xesscorp/XuLA/pcb/.solderpad/photo.jpg

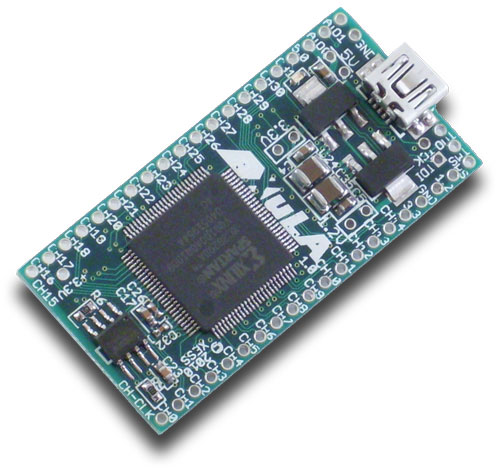
pcb/.solderpad/photo.jpg
