xesscorp/XuLA/(threads)

Thread 1 (2016-05-18):

Quartus ii 13.1 web edition failed to compile the coding

zackhaikal, 2016-05-18:
My project aims to use the DE1 SoC FPGA board for obstacle and these are the components used:
i.   ultrasonic sensor
ii.  TRDB LTM LCD
iii. TRDB D5M
when compiling the coding, i got this error
why?
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

xesscorp, 2016-05-18:
This issue isn't related to the XuLA Board in any way.

Closed 2016-05-18.
