xesscorp/XuLA/pcb/.solderpad/board.pdf

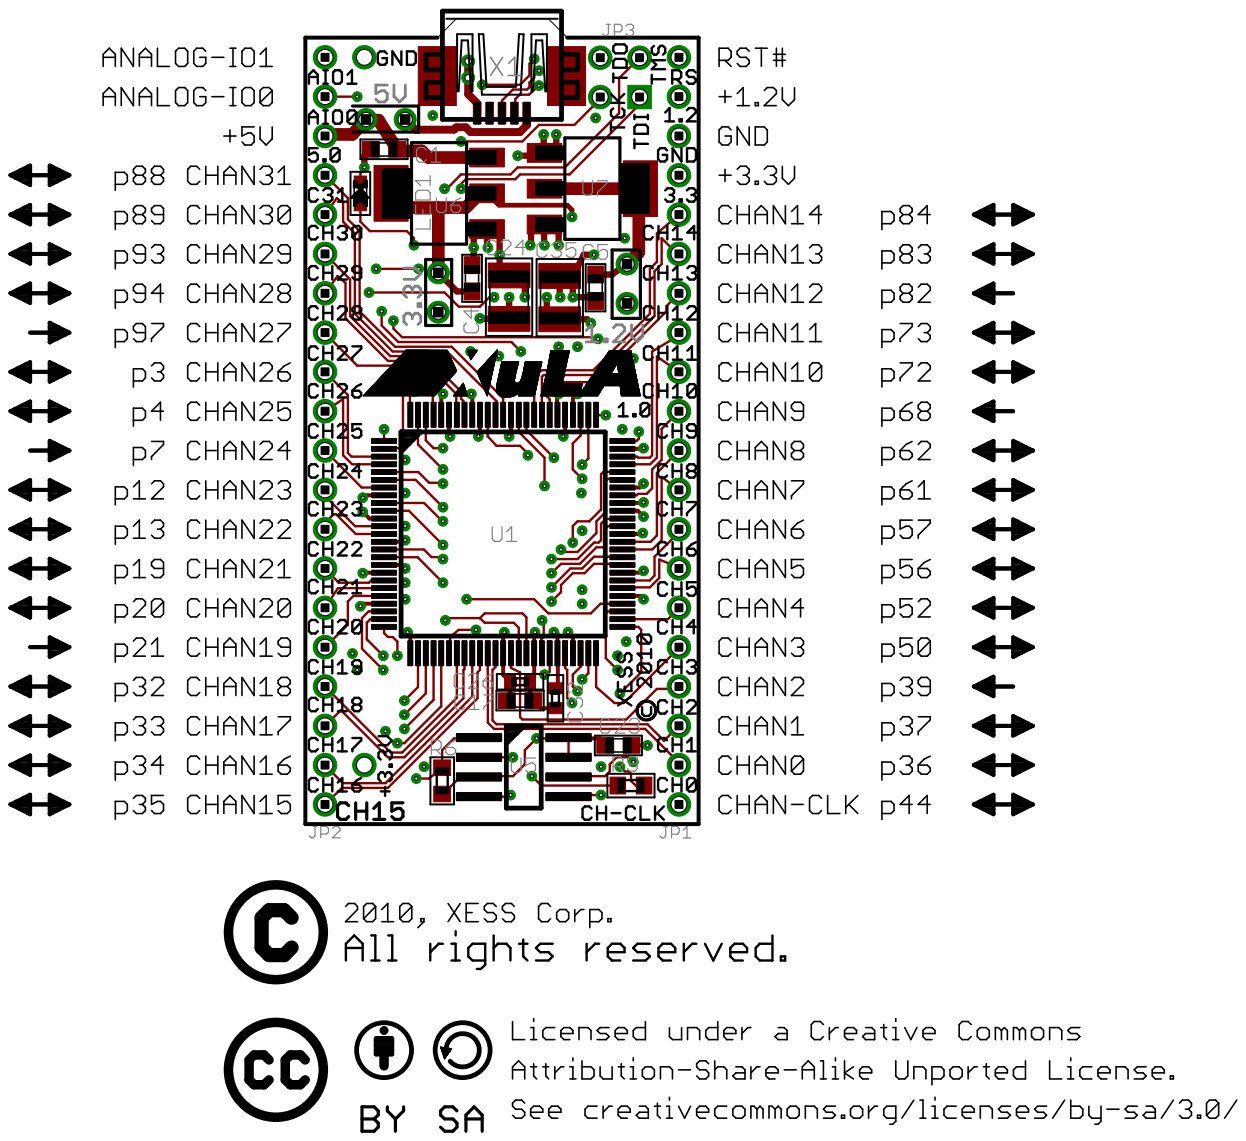
[picture p30: page 1]
