xesscorp/XuLA/pcb/.solderpad/schematic.pdf

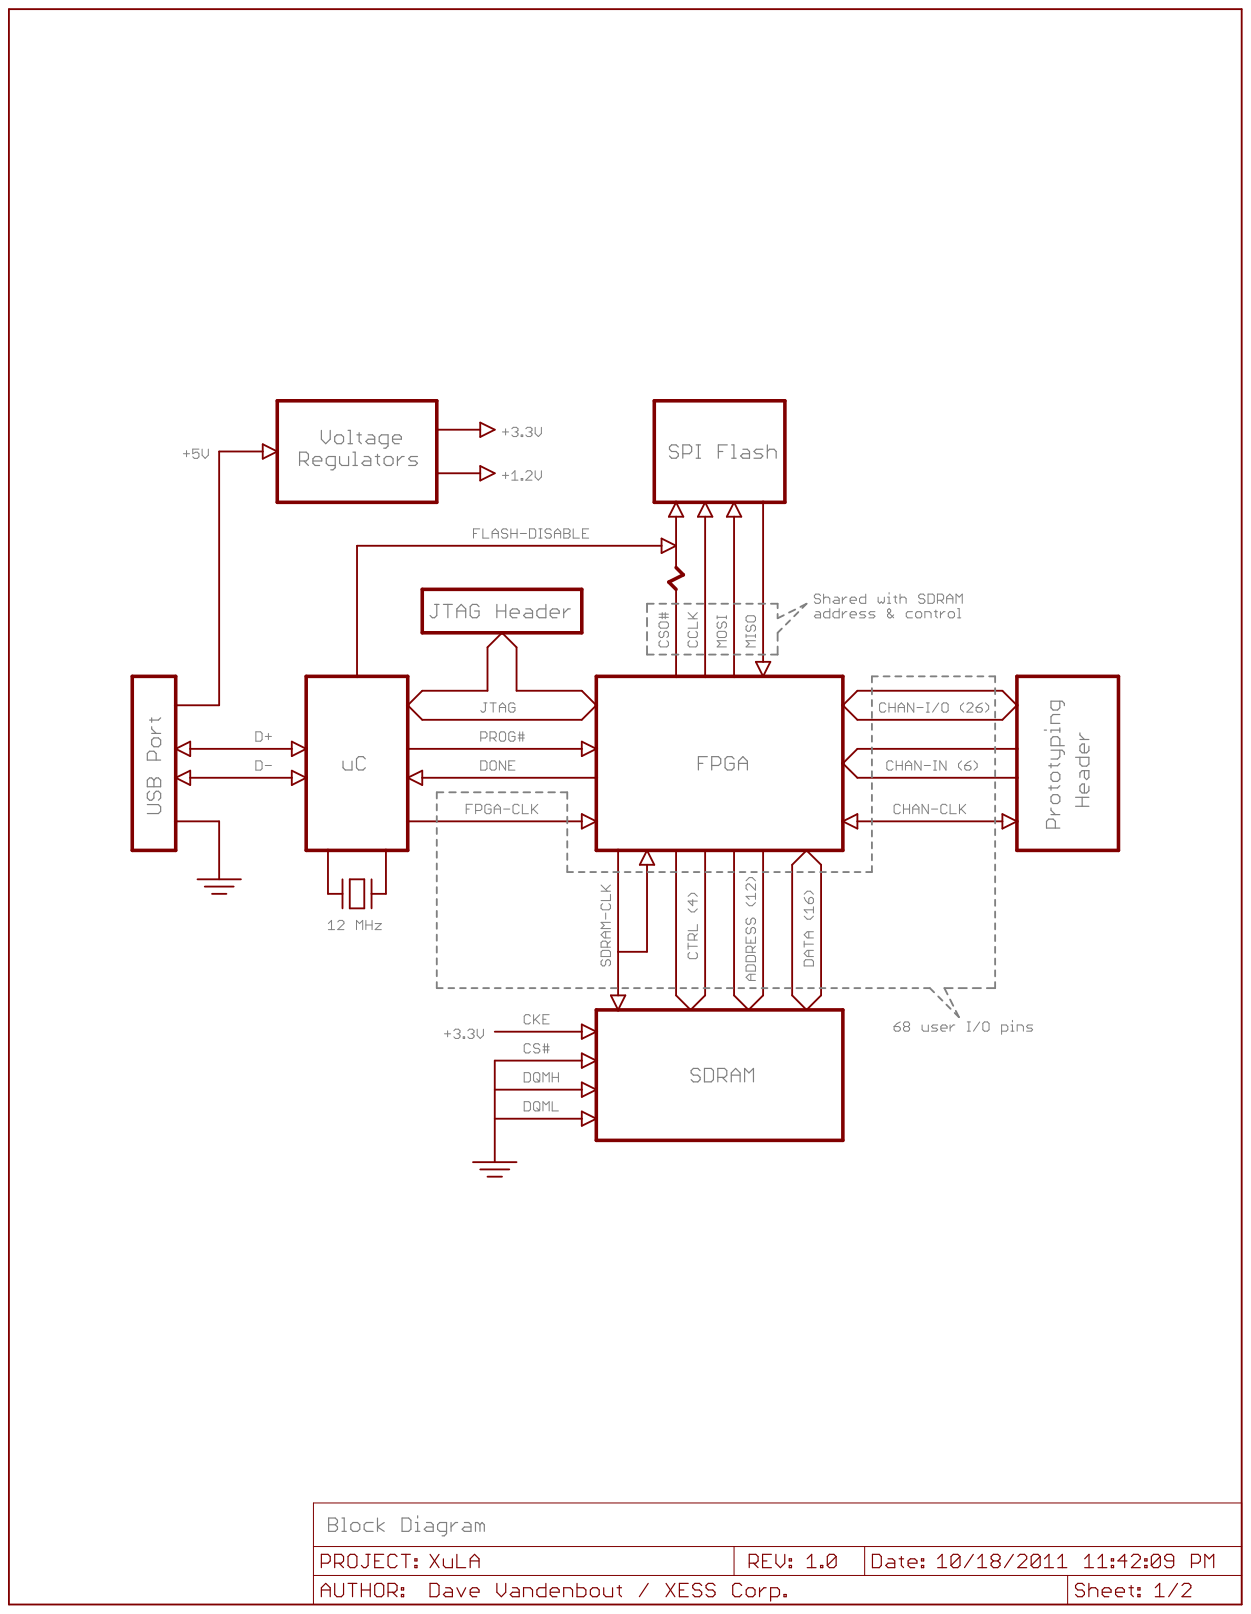
[picture p31: page 1]

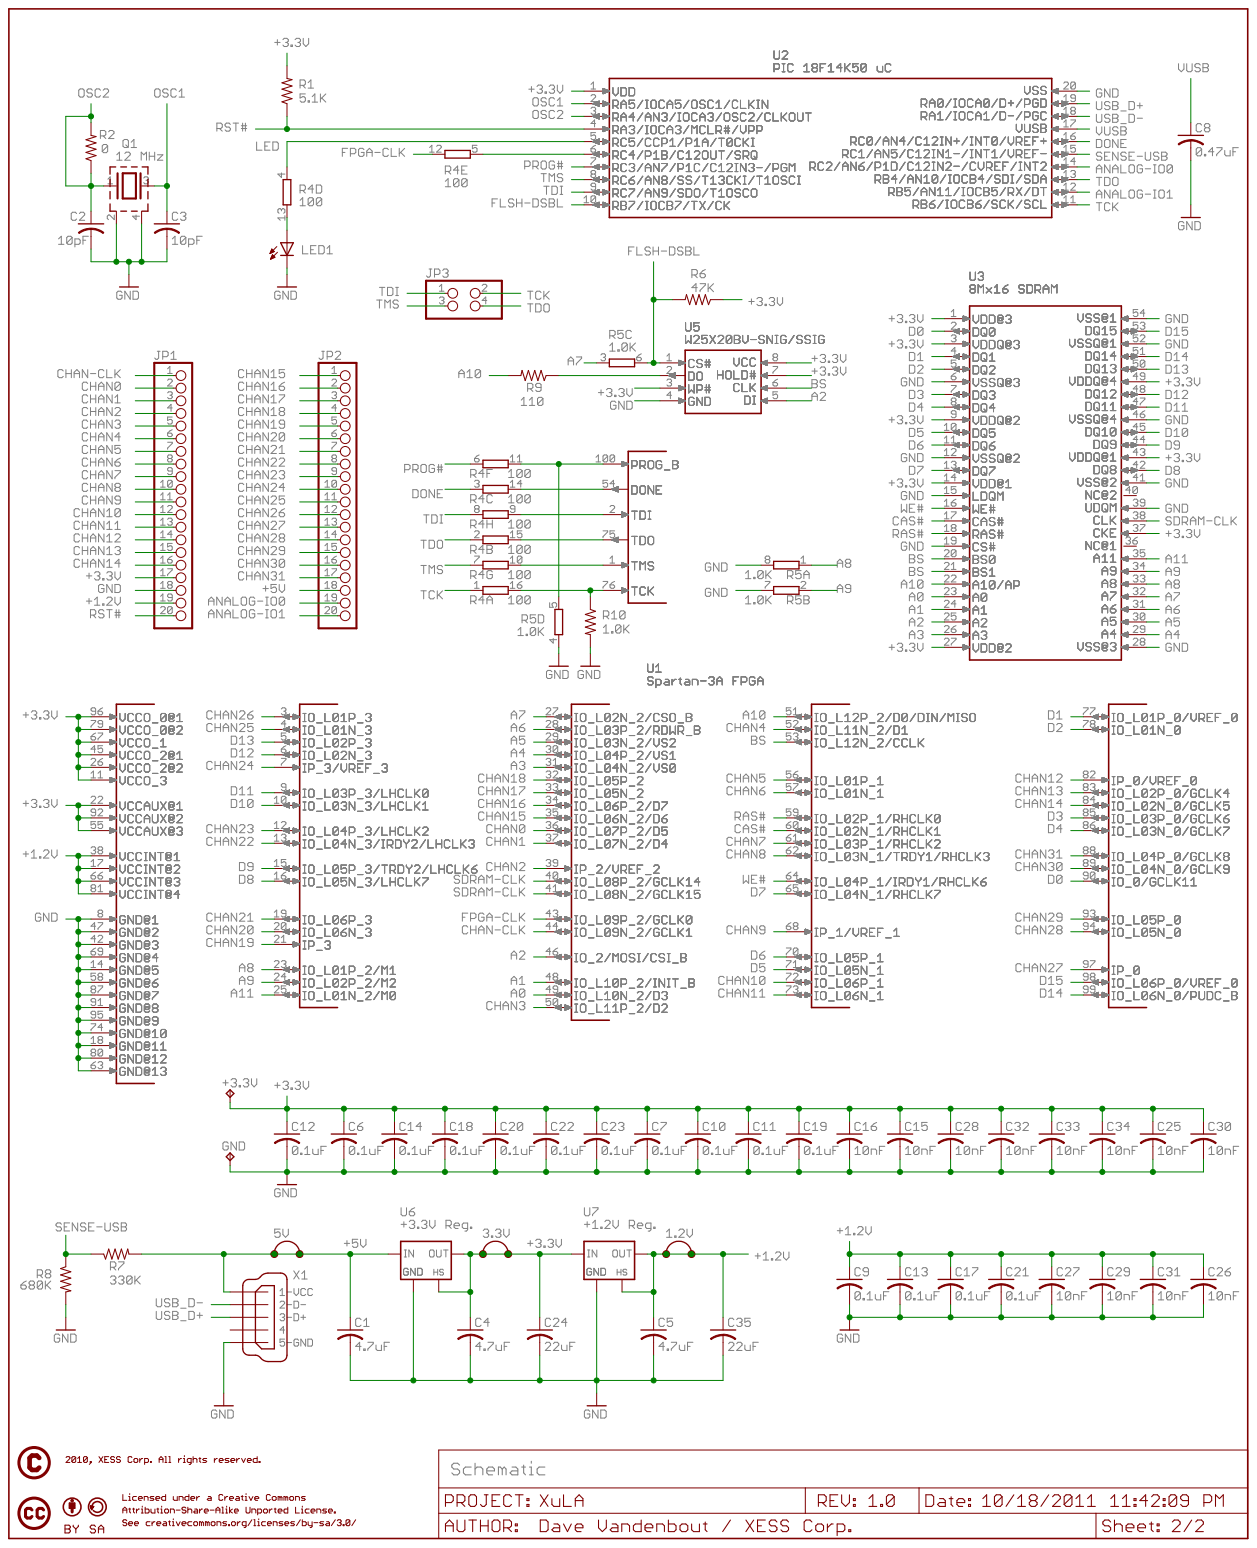
[picture p32: page 2]
