xesscorp/XuLA/fmw/user/main.c

//*********************************************************************
// Copyright (C) 2010 Dave Vanden Bout / XESS Corp. / www.xess.com
//
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
//====================================================================
//
// Module Description:
//  This module boots up the USB-to-JTAG firmware.  Look in user.c
//  for the code that does the majority of the work.
//
//********************************************************************

#include "USB/usb.h"
#include "USB/usb_function_generic.h"
#include "HardwareProfile.h"
#include "user.h"
#include "Blinker.h"

static void InitializeSystem( void );
void USBDeviceTasks( void );
void YourHighPriorityISRCode( void );
void YourLowPriorityISRCode( void );
void USBCBInitEP( void ); // This callback function was moved to user.c.

/** VECTOR REMAPPING *******************************************/
#define REMAPPED_RESET_VECTOR_ADDRESS 0x800
#define REMAPPED_HIGH_INTERRUPT_VECTOR_ADDRESS 0x808
#define REMAPPED_LOW_INTERRUPT_VECTOR_ADDRESS 0x818

#pragma code REMAPPED_RESET_VECTOR = REMAPPED_RESET_VECTOR_ADDRESS
extern void _startup( void );        // See c018i.c in your C18 compiler dir
void _reset( void )
{
    _asm goto _startup _endasm
}



#pragma code
#pragma interrupt YourHighPriorityISRCode
void YourHighPriorityISRCode()
{
    //Check which interrupt flag caused the interrupt.
    //Service the interrupt
    //Clear the interrupt flag
    //Etc.
    #if defined( USB_INTERRUPT )
    USBDeviceTasks();
    #endif
}   //This return will be a "retfie fast", since this is in a #pragma interrupt section



#pragma code REMAPPED_HIGH_INTERRUPT_VECTOR = REMAPPED_HIGH_INTERRUPT_VECTOR_ADDRESS
void Remapped_High_ISR( void )
{
    _asm goto YourHighPriorityISRCode _endasm
}



#pragma code
#pragma interruptlow YourLowPriorityISRCode
void YourLowPriorityISRCode()
{
    Blinker();
}   //This return will be a "retfie fast", since this is in a #pragma interrupt section



#pragma code REMAPPED_LOW_INTERRUPT_VECTOR = REMAPPED_LOW_INTERRUPT_VECTOR_ADDRESS
void Remapped_Low_ISR( void )
{
    _asm goto YourLowPriorityISRCode _endasm
}



#pragma code

void main( void )
{
    InitializeSystem();

    #if defined( USB_INTERRUPT )
    USBDeviceAttach();
    #endif

    while ( 1 )
    {
        #if defined( USB_POLLING )
        // Check bus status and service USB interrupts.
        USBDeviceTasks(); // Call every 100us or so (takes ~50 instruction cycles before it returns).
        #endif

        ProcessIO();
    }
}



static void InitializeSystem( void )
{
    UserInit();
    USBDeviceInit();
}



// ******************************************************************************************************
// ************** USB Callback Functions ****************************************************************
// ******************************************************************************************************
// The USB firmware stack will call the callback functions USBCBxxx() in response to certain USB related
// events.  For example, if the host PC is powering down, it will stop sending out Start of Frame (SOF)
// packets to your device.  In response to this, all USB devices are supposed to decrease their power
// consumption from the USB Vbus to <2.5mA each.  The USB module detects this condition (which according
// to the USB specifications is 3+ms of no bus activity/SOF packets) and then calls the USBCBSuspend()
// function.  You should modify these callback functions to take appropriate actions for each of these
// conditions.  For example, in the USBCBSuspend(), you may wish to add code that will decrease power
// consumption from Vbus to <2.5mA (such as by clock switching, turning off LEDs, putting the
// microcontroller to sleep, etc.).  Then, in the USBCBWakeFromSuspend() function, you may then wish to
// add code that undoes the power saving things done in the USBCBSuspend() function.

// The USBCBSendResume() function is special, in that the USB stack will not automatically call this
// function.  This function is meant to be called from the application firmware instead.  See the
// additional comments near the function.

/******************************************************************************
 * Function:        void USBCBSuspend(void)
 *
 * PreCondition:    None
 *
 * Input:           None
 *
 * Output:          None
 *
 * Side Effects:    None
 *
 * Overview:        Call back that is invoked when a USB suspend is detected
 *
 * Note:            None
 *****************************************************************************/
void USBCBSuspend( void )
{
    //Example power saving code.  Insert appropriate code here for the desired
    //application behavior.  If the microcontroller will be put to sleep, a
    //process similar to that shown below may be used:

    //ConfigureIOPinsForLowPower();
    //SaveStateOfAllInterruptEnableBits();
    //DisableAllInterruptEnableBits();
    //EnableOnlyTheInterruptsWhichWillBeUsedToWakeTheMicro();	//should enable at least USBActivityIF as a wake source
    //Sleep();
    //RestoreStateOfAllPreviouslySavedInterruptEnableBits();	//Preferrably, this should be done in the USBCBWakeFromSuspend() function instead.
    //RestoreIOPinsToNormal();									//Preferrably, this should be done in the USBCBWakeFromSuspend() function instead.

    //IMPORTANT NOTE: Do not clear the USBActivityIF (ACTVIF) bit here.  This bit is
    //cleared inside the usb_device.c file.  Clearing USBActivityIF here will cause
    //things to not work as intended.


    #if defined( __C30__ )
    #if 0
    U1EIR              = 0xFFFF;
    U1IR               = 0xFFFF;
    U1OTGIR            = 0xFFFF;
    IFS5bits.USB1IF    = 0;
    IEC5bits.USB1IE    = 1;
    U1OTGIEbits.ACTVIE = 1;
    U1OTGIRbits.ACTVIF = 1;
    Sleep();
    #endif
    #endif
} /* USBCBSuspend */



/******************************************************************************
 * Function:        void _USB1Interrupt(void)
 *
 * PreCondition:    None
 *
 * Input:           None
 *
 * Output:          None
 *
 * Side Effects:    None
 *
 * Overview:        This function is called when the USB interrupt bit is set
 *					In this example the interrupt is only used when the device
 *					goes to sleep when it receives a USB suspend command
 *
 * Note:            None
 *****************************************************************************/
#if 0
void __attribute__ ( ( interrupt ) ) _USB1Interrupt( void )
{
    #if !defined( self_powered )
    if ( U1OTGIRbits.ACTVIF )
    {
        IEC5bits.USB1IE    = 0;
        U1OTGIEbits.ACTVIE = 0;
        IFS5bits.USB1IF    = 0;

        //USBClearInterruptFlag(USBActivityIFReg,USBActivityIFBitNum);
        USBClearInterruptFlag( USBIdleIFReg, USBIdleIFBitNum );
        //USBSuspendControl = 0;
    }
    #endif
}



#endif

/******************************************************************************
 * Function:        void USBCBWakeFromSuspend(void)
 *
 * PreCondition:    None
 *
 * Input:           None
 *
 * Output:          None
 *
 * Side Effects:    None
 *
 * Overview:        The host may put USB peripheral devices in low power
 *					suspend mode (by "sending" 3+ms of idle).  Once in suspend
 *					mode, the host may wake the device back up by sending non-
 *					idle state signalling.
 *
 *					This call back is invoked when a wakeup from USB suspend
 *					is detected.
 *
 * Note:            None
 *****************************************************************************/
void USBCBWakeFromSuspend( void )
{
    // If clock switching or other power savings measures were taken when
    // executing the USBCBSuspend() function, now would be a good time to
    // switch back to normal full power run mode conditions.  The host allows
    // a few milliseconds of wakeup time, after which the device must be
    // fully back to normal, and capable of receiving and processing USB
    // packets.  In order to do this, the USB module must receive proper
    // clocking (IE: 48MHz clock must be available to SIE for full speed USB
    // operation).
}



/********************************************************************
 * Function:        void USBCB_SOF_Handler(void)
 *
 * PreCondition:    None
 *
 * Input:           None
 *
 * Output:          None
 *
 * Side Effects:    None
 *
 * Overview:        The USB host sends out a SOF packet to full-speed
 *                  devices every 1 ms. This interrupt may be useful
 *                  for isochronous pipes. End designers should
 *                  implement callback routine as necessary.
 *
 * Note:            None
 *******************************************************************/
void USBCB_SOF_Handler( void )
{
    // No need to clear UIRbits.SOFIF to 0 here.
    // Callback caller is already doing that.
}



/*******************************************************************
* Function:        void USBCBErrorHandler(void)
*
* PreCondition:    None
*
* Input:           None
*
* Output:          None
*
* Side Effects:    None
*
* Overview:        The purpose of this callback is mainly for
*                  debugging during development. Check UEIR to see
*                  which error causes the interrupt.
*
* Note:            None
*******************************************************************/
void USBCBErrorHandler( void )
{
    // No need to clear UEIR to 0 here.
    // Callback caller is already doing that.

    // Typically, user firmware does not need to do anything special
    // if a USB error occurs.  For example, if the host sends an OUT
    // packet to your device, but the packet gets corrupted (ex:
    // because of a bad connection, or the user unplugs the
    // USB cable during the transmission) this will typically set
    // one or more USB error interrupt flags.  Nothing specific
    // needs to be done however, since the SIE will automatically
    // send a "NAK" packet to the host.  In response to this, the
    // host will normally retry to send the packet again, and no
    // data loss occurs.  The system will typically recover
    // automatically, without the need for application firmware
    // intervention.

    // Nevertheless, this callback function is provided, such as
    // for debugging purposes.
}



/*******************************************************************
 * Function:        void USBCBCheckOtherReq(void)
 *
 * PreCondition:    None
 *
 * Input:           None
 *
 * Output:          None
 *
 * Side Effects:    None
 *
 * Overview:        When SETUP packets arrive from the host, some
 *                  firmware must process the request and respond
 *					appropriately to fulfill the request.  Some of
 *					the SETUP packets will be for standard
 *					USB "chapter 9" (as in, fulfilling chapter 9 of
 *					the official USB specifications) requests, while
 *					others may be specific to the USB device class
 *					that is being implemented.  For example, a HID
 *					class device needs to be able to respond to
 *					"GET REPORT" type of requests.  This
 *					is not a standard USB chapter 9 request, and
 *					therefore not handled by usb_device.c.  Instead
 *					this request should be handled by class specific
 *					firmware, such as that contained in usb_function_hid.c.
 *
 * Note:            None
 *****************************************************************************/
void USBCBCheckOtherReq( void )
{
} //end



/*******************************************************************
 * Function:        void USBCBStdSetDscHandler(void)
 *
 * PreCondition:    None
 *
 * Input:           None
 *
 * Output:          None
 *
 * Side Effects:    None
 *
 * Overview:        The USBCBStdSetDscHandler() callback function is
 *					called when a SETUP, bRequest: SET_DESCRIPTOR request
 *					arrives.  Typically SET_DESCRIPTOR requests are
 *					not used in most applications, and it is
 *					optional to support this type of request.
 *
 * Note:            None
 *****************************************************************************/
void USBCBStdSetDscHandler( void )
{
    // Must claim session ownership if supporting this request
} //end



/******************************************************************************
 * Function:        void USBCBInitEP(void)
 *
 * PreCondition:    None
 *
 * Input:           None
 *
 * Output:          None
 *
 * Side Effects:    None
 *
 * Overview:        This function is called when the device becomes
 *                  initialized, which occurs after the host sends a
 *                  SET_CONFIGURATION (wValue not = 0) request.  This
 *					callback function should initialize the endpoints
 *					for the device's usage according to the current
 *					configuration.
 *
 * Note:            None
 *****************************************************************************/
// This callback function was moved to user.c.


/********************************************************************
 * Function:        void USBCBSendResume(void)
 *
 * PreCondition:    None
 *
 * Input:           None
 *
 * Output:          None
 *
 * Side Effects:    None
 *
 * Overview:        The USB specifications allow some types of USB
 *                  peripheral devices to wake up a host PC (such
 *					as if it is in a low power suspend to RAM state).
 *					This can be a very useful feature in some
 *					USB applications, such as an Infrared remote
 *					control	receiver.  If a user presses the "power"
 *					button on a remote control, it is nice that the
 *					IR receiver can detect this signalling, and then
 *					send a USB "command" to the PC to wake up.
 *
 *					The USBCBSendResume() "callback" function is used
 *					to send this special USB signalling which wakes
 *					up the PC.  This function may be called by
 *					application firmware to wake up the PC.  This
 *					function should only be called when:
 *
 *					1.  The USB driver used on the host PC supports
 *						the remote wakeup capability.
 *					2.  The USB configuration descriptor indicates
 *						the device is remote wakeup capable in the
 *						bmAttributes field.
 *					3.  The USB host PC is currently sleeping,
 *						and has previously sent your device a SET
 *						FEATURE setup packet which "armed" the
 *						remote wakeup capability.
 *
 *					This callback should send a RESUME signal that
 *                  has the period of 1-15ms.
 *
 * Note:            Interrupt vs. Polling
 *                  -Primary clock
 *                  -Secondary clock ***** MAKE NOTES ABOUT THIS *******
 *                   > Can switch to primary first by calling USBCBWakeFromSuspend()

 *                  The modifiable section in this routine should be changed
 *                  to meet the application needs. Current implementation
 *                  temporary blocks other functions from executing for a
 *                  period of 1-13 ms depending on the core frequency.
 *
 *                  According to USB 2.0 specification section 7.1.7.7,
 *                  "The remote wakeup device must hold the resume signaling
 *                  for at lest 1 ms but for no more than 15 ms."
 *                  The idea here is to use a delay counter loop, using a
 *                  common value that would work over a wide range of core
 *                  frequencies.
 *                  That value selected is 1800. See table below:
 *                  ==========================================================
 *                  Core Freq(MHz)      MIP         RESUME Signal Period (ms)
 *                  ==========================================================
 *                      48              12          1.05
 *                       4              1           12.6
 *                  ==========================================================
 *                  * These timing could be incorrect when using code
 *                    optimization or extended instruction mode,
 *                    or when having other interrupts enabled.
 *                    Make sure to verify using the MPLAB SIM's Stopwatch
 *                    and verify the actual signal on an oscilloscope.
 *******************************************************************/
void USBCBSendResume( void )
{
    static WORD delay_count;

    USBResumeControl = 1;                // Start RESUME signaling

    delay_count      = 1800U;           // Set RESUME line for 1-13 ms
    do
        delay_count--;
    while ( delay_count );
    USBResumeControl = 0;
}



/*******************************************************************
* Function:        BOOL USER_USB_CALLBACK_EVENT_HANDLER(
*                        USB_EVENT event, void *pdata, WORD size)
*
* PreCondition:    None
*
* Input:           USB_EVENT event - the type of event
*                  void *pdata - pointer to the event data
*                  WORD size - size of the event data
*
* Output:          None
*
* Side Effects:    None
*
* Overview:        This function is called from the USB stack to
*                  notify a user application that a USB event
*                  occured.  This callback is in interrupt context
*                  when the USB_INTERRUPT option is selected.
*
* Note:            None
*******************************************************************/
BOOL USER_USB_CALLBACK_EVENT_HANDLER( USB_EVENT event, void *pdata, WORD size )
{
    switch ( event )
    {
        case EVENT_CONFIGURED:
            USBCBInitEP();
            break;

        case EVENT_SET_DESCRIPTOR:
            USBCBStdSetDscHandler();
            break;

        case EVENT_EP0_REQUEST:
            USBCBCheckOtherReq();
            break;

        case EVENT_SOF:
            USBCB_SOF_Handler();
            break;

        case EVENT_SUSPEND:
            USBCBSuspend();
            break;

        case EVENT_RESUME:
            USBCBWakeFromSuspend();
            break;

        case EVENT_BUS_ERROR:
            USBCBErrorHandler();
            break;

        case EVENT_TRANSFER:
            Nop();
            break;

        default:
            break;
    } /* switch */
    return TRUE;
} /* USER_USB_CALLBACK_EVENT_HANDLER */
