xesscorp/XuLA/FPGA/200/blinker/blinker.ucf

net clk_i     loc=p43;  # 12 MHz input clock.
net blinker_o loc=p44 | IOSTANDARD=LVTTL | DRIVE=24 | SLEW=SLOW ;  # Blinker output to LED.
