xesscorp/XuLA/FPGA/200/HostIoToI2c/HostIoToI2cTest.ucf

net fpgaClk_i loc=p43 | IOSTANDARD = LVTTL;
net scl_io    loc=p32 | IOSTANDARD = LVTTL;
net sda_io    loc=p50 | IOSTANDARD = LVTTL;
