xesscorp/XuLA/(commit log)

2010-08-28 Initial version.
    [XuLA.brd, XuLA.sch]
2010-09-02 - I/O pin configuration. - Change boot block size in configuration bits. - FPGA clock generation. - Clean up.
2010-09-04 Modifications for XuLA board. Not working. Boots but fails to link with USB.
    [main.c, user.c]
2010-09-04 Modifications for XuLA board.
2010-09-10 Updated to use Microchip USB Framework 2.7a.
2010-09-22 - Modified INFO_CMD for product and version information. - Use received packet length instead of assuming USBGEN_SIZE. - Added TDI,TDO commands from XSUSB firmware. - Moved blinker interrupt routine 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
2010-09-23 - Fixed multi-packet TAP_SEQ_CMD operation. - Enabled FPGA clock. - Enabled FPGA configuration by raising PROGB pin.
    [user.c]
2010-09-23 - Enabled fast slew-rate for ports A, B, C. - FPGA clock reduced to a single pin because slew-rate was increased.
2010-09-23 - Fixed #pragma for low-priority interrupt handler.
    [main.c]
2010-09-23 - Fixed PWM steering so P1A is shut-off and won't interfere with LED driver pin.
2010-10-03 This is version 0.1 of XuLA.
    [XuLA.brd, XuLA.sch]
2010-10-04 DESIGN CHANGES ======================================================================== 1. Move and thin shorts on +5V, +3.3V and +1.2V jumpers so they are easier to cut without cutting nearby wires.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
    [XuLA.brd, XuLA.sch]
2010-10-06 Added I/O pin to disable SPI flash.
2010-10-08 Ammended block diagram for changes in schematic.
    [XuLA.brd, XuLA.sch]
2010-10-08 - Added net labels to board headers. - Removed overlap of resistor label and value in schematic.
    [XuLA.brd, XuLA.sch]
2010-10-08 - Bootloader for XuLA prototype 0.1.
2010-10-10 Changes for XuLA PCB version 0.2: - Removed delay before checking FMW update jumper. - Changed I/O pin assignments.
2010-10-11 - Added 510 ohm pulldown to TCK pin of FPGA to overcome the built-in pullup. - PCB version on silkscreen is now controlled by the VERSION# attribute.
    [XuLA.brd, XuLA.sch]
2010-10-13 Layout changes: - Moved JP1 & JP2 leftward and shortened PCB. - Moved capacitors and other components. - Added connector for external JTAG.
    [XuLA.brd, XuLA.sch]
2010-11-25 Changes for release version 1.0.
    [XuLA-SEP_array.brd, XuLA.brd, XuLA.sch]
2010-11-28 Changed FPGA to XC3S in 256FT BGA package. Changed SDRAM to Winbond W9825 256-Mbit.
    [XuLA.brd, XuLA.sch]
2010-12-18 Changes for re-flashing micro firmware. Changes for EEPROM flags. Changes for pin re-assignments in production PCB.
2010-12-18 Added commands for read/write of EEPROM, enable/disable of Flash. Changes for pin re-assignments in production PCB. Re-enabled old JTAG commands for use by XSTOOLs utilities.
2011-03-15 * Improved/simplified/corrected TAP_SEQ_CMD instruction. * Changed TAP_SEQ_CMD to JTAG_CMD.
    [user.c]
2011-08-20 Simplified PrintBits().
2011-08-20 Recompiled to reflect change in PrintBits().
2011-08-25 Added subtractor module attached to HostIoToDut module.
2011-10-19 Merging Branch_V1.0 into master.
    [XuLA.brd, XuLA.sch]
2011-10-19 Added schematic and board PDFs for Solderpad site.
2011-10-19 Added BOM in JSON format.
2012-04-04 - Added documentation and misc files.
    [clk_freqs.xls]
2012-04-16 - Modified board self-test to use HostIo to initiate and query the diagnostic.
2012-04-18 - Added ODDR2 to bridge generated clock to output pin in Spartan6.
2012-05-10 Increased drive strength of LED driver output.
2012-05-10 Pin assignments for XuLA2 board with Spartan6 FPGA.
2012-05-10 Split clock network => logic fabric differential driver out of clock generator.
2012-05-10 Moved board test diagnostic back to old JTAG interface.
2012-05-10 Added new board test diagnostic based on HostIo interface.
2012-05-10 Created board test diagnostic and RAM I/O using old-style JTAG interface.
2012-05-10 Created board test diagnostic and RAM I/O based on HostIo interface.
2012-09-20 Scanner for StickIt! buttons module.
2012-09-20 Driver for StickIt! LED digits module.
2012-09-20 Interface to HCSR04 ultrasonic range finder.
2012-09-20 Scanner for a rotary encoder.
2012-09-24 Added pin assignments to the ultrasonic range finder example.
2012-09-24 Added ultrasonic range finder to list of examples.
2012-12-28 Expanded explanation of how to use a XILINX cable with the XuLA.
2012-12-30 Added I2C interface module and its associated HostIo interface.
2013-01-02 Added the ability to read voltages up to 2.048V on the analog I/O pins.
2013-05-10 + Added design for reading/writing the serial configuration flash on the XuLA board. + Added SPI interface module. + Added I2C interface module.
2013-11-08 Documented rotary encoder module.
